Fluburtur/flubogenV2/remote/README.md

# Remote Control

Remote control of the protobrain.

## Nano Remote V1

Currently this is the only design. To build the software, open `remote_nano_v1/remote_nano_v1.ino` in the Arduino IDE.
