Fluburtur/flubogenV2/remote/nano schematic v1.jpg

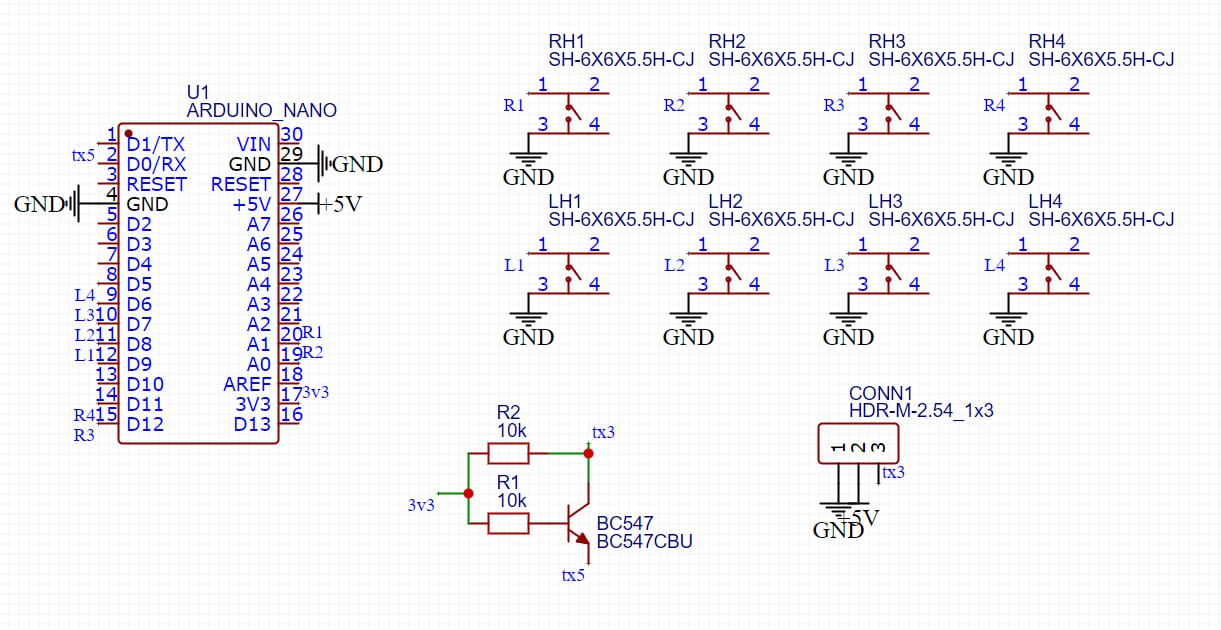
remote/nano schematic v1.jpg
