Fluburtur/flubogenV2/remote/remote_nano_v1/config.h

#pragma once

/* Global configuration for the remote.
 * This should be the first #include in any files that use it. */

/* Uncomment the defines below to enable some debugging behaviours. */

//#define MAIN_DEBUGGING
//#define BUTT2MOD_DEBUGGING
//#define CONNECTED_FSM_DEBUGGING
//#define MESSAGES_DEBUGGING_HUMAN_READABLE
