Fluburtur/flubogenV2/protobrain2/src/leds/led_brightness.c

#include <math.h>

#include <pico/assert.h>

#include "led_brightness.h"

#include "adc_sensors.h"
#include "misc.h"
#include "ws2812b.h"

/** The hardware can be driven up to 255, but we limit to 150 due to power supply limitations. */
#define MAX_BRIGHTNESS_FACE 150
/** The logos can be driven at full power, no problem. */
#define MAX_BRIGHTNESS_LOGO 255

#define MAX_GAMMA 1.9
#define MIN_GAMMA 1.2

/* Maps an ADC sensor value to an automatic brightness level. */
typedef struct
{
    /* Input ADC sensor value. */
    uint16_t adc_max;
    /* Output brightness level. */
    uint8_t brightness;
} brightness_level_t;

/* Maps an ADC sensor value to an automatic face brightness level.
 * Must be ordered from low to high sensor value. */
static const brightness_level_t auto_brightness_levels_face[] = {
    {1300, 10},
    {1800, 13},
    {2300, 20},
    {2700, 30},
    {3100, 50},
    {3300, 73},
    {3500, 100},
    {3798, 128},
    {4095, MAX_BRIGHTNESS_FACE},
};

/* Maps an ADC sensor value to an automatic logo brightness level.
 * Must be ordered from low to high sensor value. */
static const brightness_level_t auto_brightness_levels_logo[] = {
    {1300, 30},
    {1800, 35},
    {2300, 47},
    {2700, 64},
    {3100, 100},
    {3300, 144},
    {3500, 187},
    {3798, 225},
    {4095, MAX_BRIGHTNESS_LOGO},
};

/* The automatically chosen brightness limit for the face. */
static uint8_t brightness_limit_face;
/* The automatically chosen brightness limit for the logo. */
static uint8_t brightness_limit_logo;

/* The .fur file has the animation's RGB values in the range 0-255.
 * Map these to the range 0 to `brightness_limit_face` */
static uint8_t brightness_map_face[256] = {};

static uint8_t sensor_value_to_auto_brightness(
    uint16_t adc_value, const brightness_level_t *table, uint8_t n_table_entries);
static void update_brightness_map_face(double brightness_limit);

void led_brightness_init(uint16_t adc_brightness)
{
    /* Set to invalid values to force an update. */
    brightness_limit_face = 0;
    brightness_limit_logo = 0;
    led_brightness_update(adc_brightness);

    printDebug(
        "Face and logo brightness initialised to %u, %u\n",
        brightness_limit_face, brightness_limit_logo);
}

void led_brightness_update(uint16_t adc_brightness)
{
    uint8_t old_brightness_limit_face = brightness_limit_face;

    brightness_limit_face = sensor_value_to_auto_brightness(
        adc_brightness, auto_brightness_levels_face, ARRAY_NELEMS(auto_brightness_levels_face));
    if (brightness_limit_face != old_brightness_limit_face)
    {
        update_brightness_map_face(brightness_limit_face);
    }

    brightness_limit_logo = sensor_value_to_auto_brightness(
        adc_brightness, auto_brightness_levels_logo, ARRAY_NELEMS(auto_brightness_levels_logo));
}

const uint8_t *led_brightness_get_face_map(void)
{
    return brightness_map_face;
}

ws2812b_led_value_t led_brightness_get_logo_colour(ws2812b_led_value_t base_colour)
{
    /* `base_colour` is the user's chosen logo colour before brightness limiting.
     * `brightness_limit_logo` is the current brightness limit.
     * `fraction` is the fraction of the current brightness limit out of the maximum possible
     * brightness, with values from 0 to 1. */
    float fraction = brightness_limit_logo / (float)MAX_BRIGHTNESS_LOGO;
    return (ws2812b_led_value_t){
        .r = base_colour.r * fraction,
        .g = base_colour.g * fraction,
        .b = base_colour.b * fraction
    };
}

/**
 * Convert an ADC sensor value to an automatic brightness.
 *
 * @param[in] adc_value
 * @param[in] table Lookup table. Must be ordered from low to high sensor value.
 * @param[in] n_table_entries How many entries in the table.
 */
static uint8_t sensor_value_to_auto_brightness(
    uint16_t adc_value, const brightness_level_t *table, uint8_t n_table_entries)
{
    uint8_t last_table_idx = n_table_entries - 1;
    /* The mapping is step-wise.
     * The brightness is x until the first sensor value, y until the second sensor value... */
    for (uint8_t i = 0; i <= last_table_idx; i++)
    {
        if (adc_value < table[i].adc_max)
        {
            return table[i].brightness;
        }
    }

    return table[last_table_idx].brightness;
}

/**
 * Update the face brightness map.
 *
 * @param[in] brightness_limit The chosen brightness limit.
 */
static void update_brightness_map_face(double brightness_limit)
{
    hard_assert(brightness_limit <= (double)MAX_BRIGHTNESS_FACE);

    // TODO: Make this fixed-point
    double gamma = MAX_GAMMA - ((255.0 - brightness_limit) / 255.0) * (MAX_GAMMA - MIN_GAMMA);
    double a = brightness_limit / pow(255.0, gamma);

    for (uint16_t i = 0; i < 256; i++)
    {
        brightness_map_face[i] = round(a * pow(i, gamma));
    }
}
