Fluburtur/flubogenV2/protobrain2/src/leds/led_brightness.h

/*
 * Automatic LED brightness adjustment for the face and logos.
 *
 * LED brightness is updated continuously, based on an ambient light sensor.
 *
 * The brightness adjustment serves 3 purposes:
 *   - Limit the max brightness so we don't draw too much power.
 *   - Automatically adjust the brightness so we don't blind people in dark rooms.
 *   - A linear input to a non-linear output, for gamma correction.
 */

#ifndef _LED_BRIGHTNESS_H_
#define _LED_BRIGHTNESS_H_

#include <stdint.h>

#include "ws2812b.h"

/**
 * Initialise the LED brightness module.
 *
 * @param[in] adc_brightness The current ADC brightness sensor value.
 */
void led_brightness_init(uint16_t adc_brightness);

/**
 * Update the brightness given an ADC brightness sensor value.
 *
 * @param[in] adc_brightness The current ADC brightness sensor value.
 */
void led_brightness_update(uint16_t adc_brightness);

/**
 * Get the LED brightness map for the face.
 *
 * The map contains 255 values.
 * The index is an input R/G/B value in the range 0-255.
 * The output is an R/G/B value in the range 0 to the safe value.
 */
const uint8_t *led_brightness_get_face_map(void);

/**
 * Apply brightness limits to a base logo colour.
 *
 * E.g. if the base colour is 200,0,0 and the brightness is limited to 50%, the
 * result will be 100,0,0
 *
 * @param[in] base_colour The user's chosen logo colour before brightness limiting.
 * @return The colour adjusted for brightness.
 */
ws2812b_led_value_t led_brightness_get_logo_colour(ws2812b_led_value_t base_colour);

#endif /* _LED_BRIGHTNESS_H_ */
