Fluburtur/flubogenV2/remote/remote_nano_v1/messages.h

#pragma once

/* Sending and receiving remote protocol messages via the serial. */

#define HELLO_INTERVAL_MS 1000

enum msg_from_brain_t
{
    MSG_FROM_BRAIN_NONE,
    MSG_FROM_BRAIN_RESET,
    MSG_FROM_BRAIN_START,
};

/* Receive a message without blocking. */
msg_from_brain_t try_receive_message();

void send_message_hello();
void send_message_toggle_lock();
void send_message_play_animation_once(uint8_t animation_number);
void send_message_play_animation_repeat(uint8_t animation_number);
void send_message_end_animation();
