Fluburtur/flubogenV2/(commit log)

2025-11-16 Add a PIO-based driver for the WS2812B LEDs
2025-11-16 Add an "leds" module for some higher-level functionality
2025-11-16 Display some test patterns on the 4 LED outputs
2025-11-24 Make the SD card optional
    Support for the SD card is now a compile-time option.
    When enabled, the existing SD card driver is used.
    When disabled, a fake SD card driver is used, and some animations are
    baked into the firmware.
2025-11-24 Update the leds API
2025-11-24 Adapt the animation code to the leds API
2025-11-24 Notes on gamma correction
    [gamma_correction.ods]
2025-11-30 The main loop uses the work queue
    It doesn't make much difference now, but this should make the main
    loop more manageable as complexity grows.
    [main.c]
2025-11-30 Consolidate the old ADC code
    With small tweak to the API.
2025-11-30 Feed ADC readings into the auto brightness
2025-11-30 Add the remaining LED brightness operations to main
2025-12-01 Set the logo LEDs to static blue
2025-12-02 Remove the manual brightness adjustment
    It's no longer needed.
    [led_brightness.c, led_brightness.h, main.c, work_queue.h]
2025-12-02 Do auto brightness for the logo LEDs too
2025-12-04 Can get the current animation name
    Now supports command animations too.
2025-12-05 Fix an OSD text clearing bug
    [osd.c]
2026-01-28 Add remote schematic
2026-01-31 Add the original Button2 library source
2026-02-10 Simplify and customise the button library
    Remove a lot of features we don't care about.
    Simplify how debouncing works.
    Report what we want, when we want.
2026-02-10 Top level skeleton
    Set up the hardware, send "Hello", wait for "Start".
    Handle "Reset".
    [connected_fsm.h, messages.cpp, messages.h, remote_nano_v1.ino]
2026-02-10 The connected FSM shows button states changing in realtime
    This is an intermediate step. Just checking that Butt2Mod and
    ButtonsBits are working properly, and that the concept is reasonable.
2026-02-10 Add a nice system for mapping button combinations to animations
    Can play a one-shot animation for one-button clicks or chord clicks.
2026-02-10 Disable all the debug printing
2026-02-14 Skeleton for remote comms
    Does the basic hello & start, reset, error handling.
    Animation and lock commands are ignored for now.
    [main.c, remote.c, remote.h, remote_msg.h, remote_work.h, work_queue.h]
2026-02-14 Add a "debug USB" variant of the remote
    Uses USB stdio instead of hardware UART.
2026-02-14 Slightly more consistent switch-case formatting
    It's still gross...
2026-02-17 Fix UART rx
